Juander28/TFT-MMM-LAB-PDK/docs/figures/klayout_cap.png

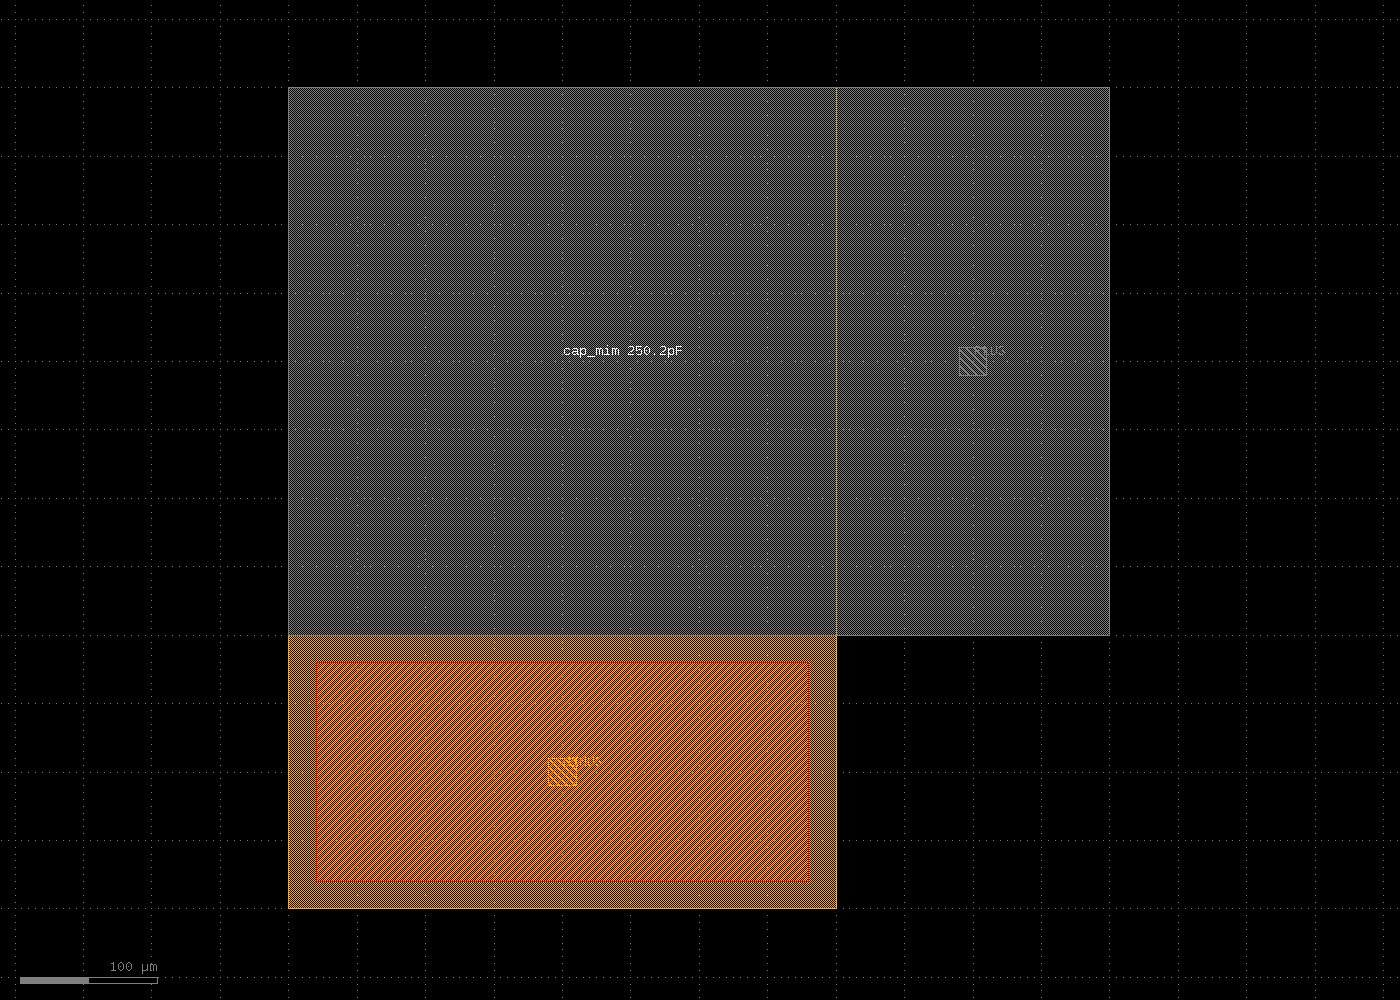
docs/figures/klayout_cap.png
