Juander28/TFT-MMM-LAB-PDK/docs/figures/klayout_cap_40p36.png

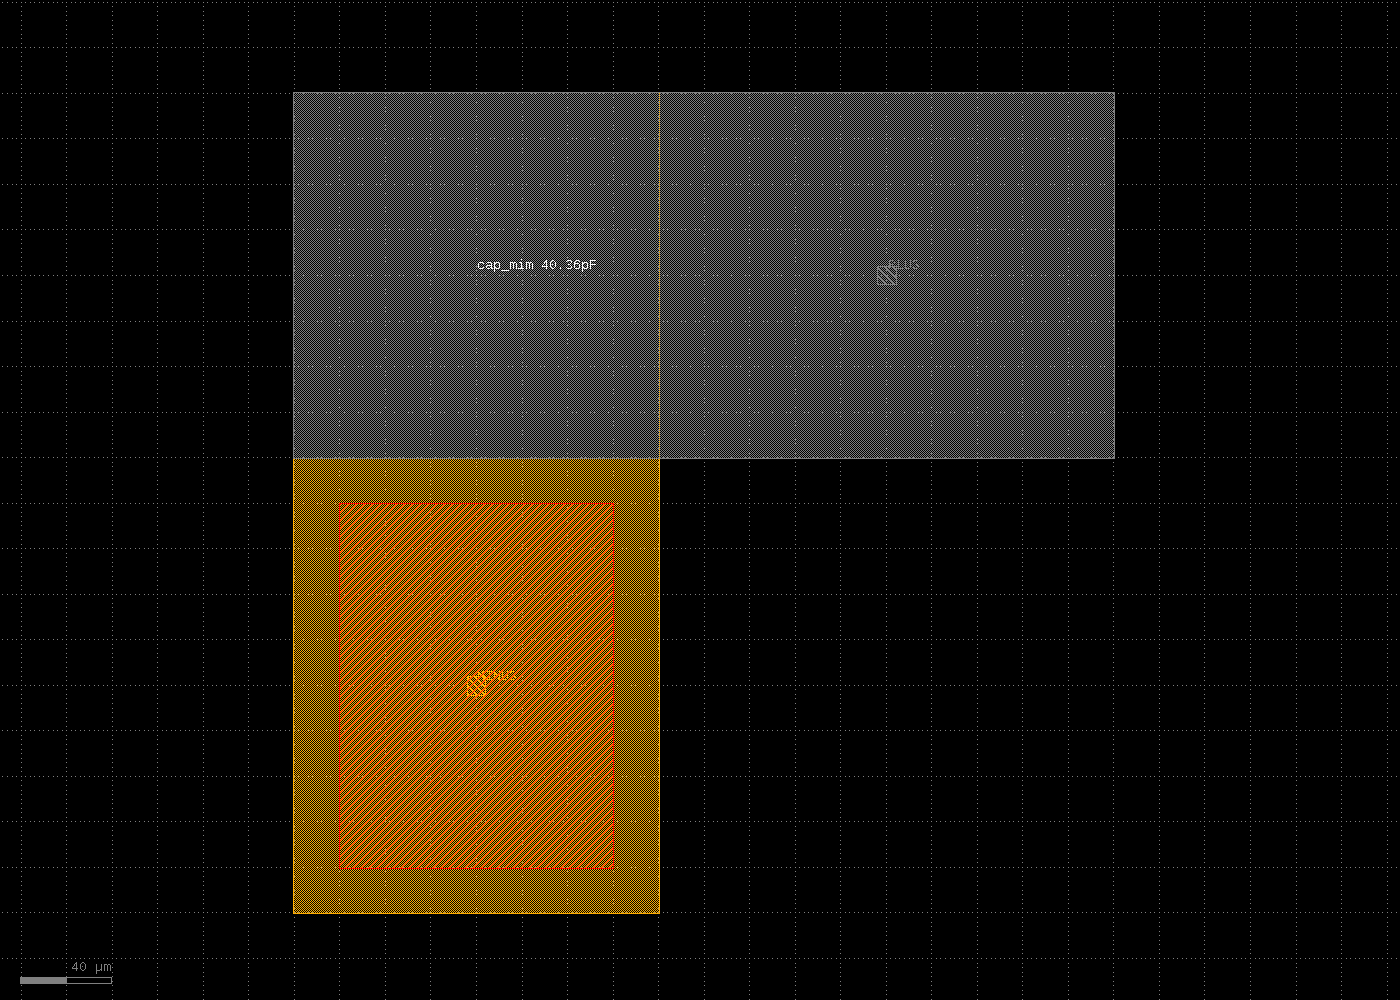
docs/figures/klayout_cap_40p36.png
