Juander28/TFT-MMM-LAB-PDK/docs/figures/klayout_ind_ci_series.png

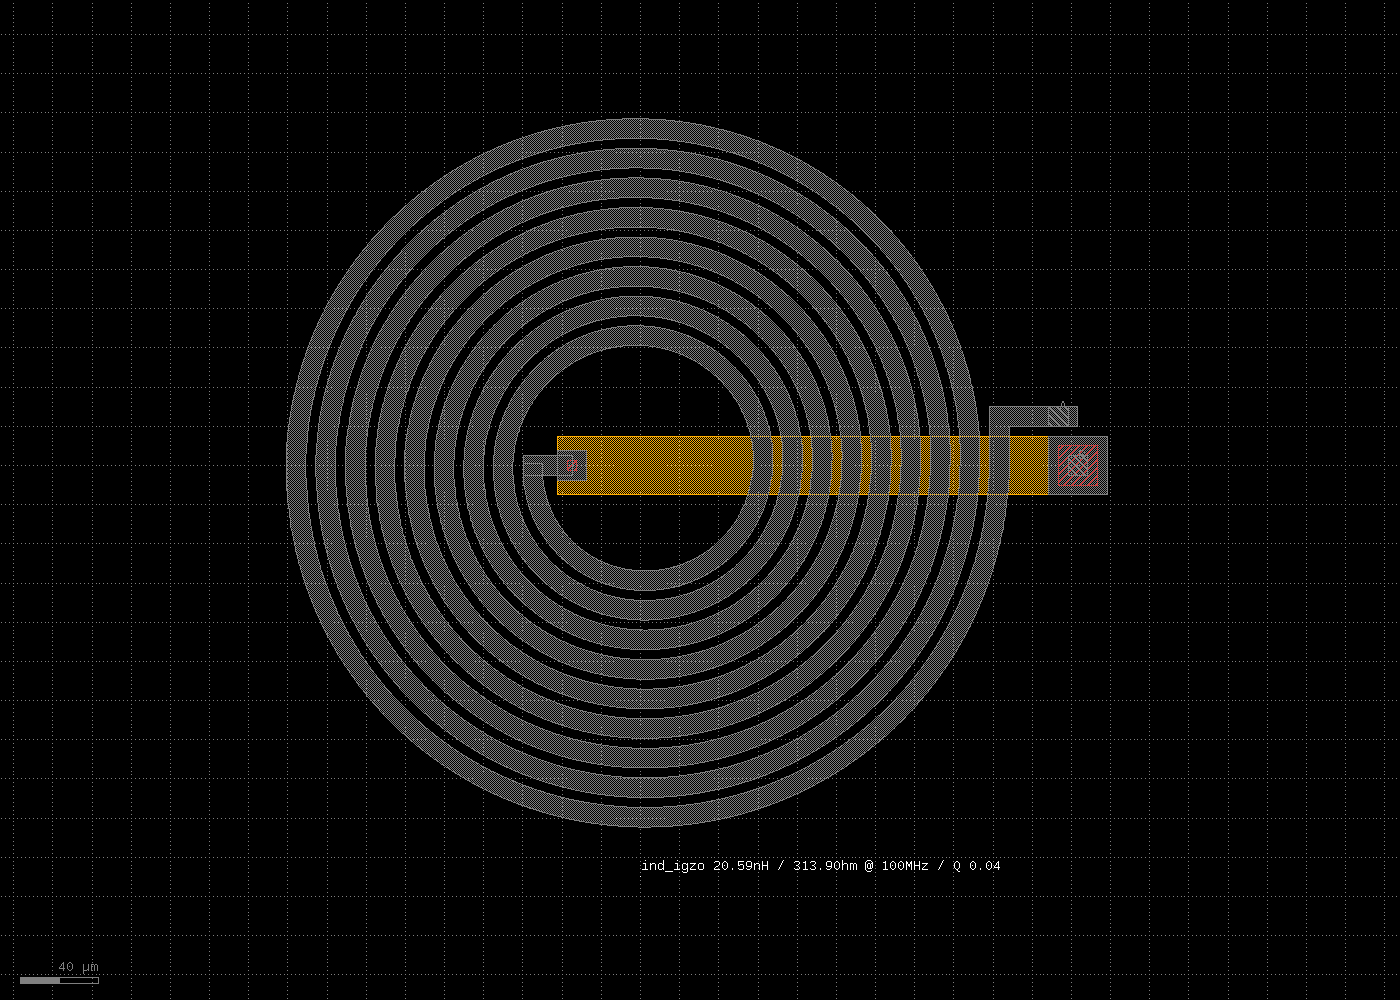
docs/figures/klayout_ind_ci_series.png
