Juander28/TFT-MMM-LAB-PDK/docs/figures/klayout_ind_sq_parallel.png

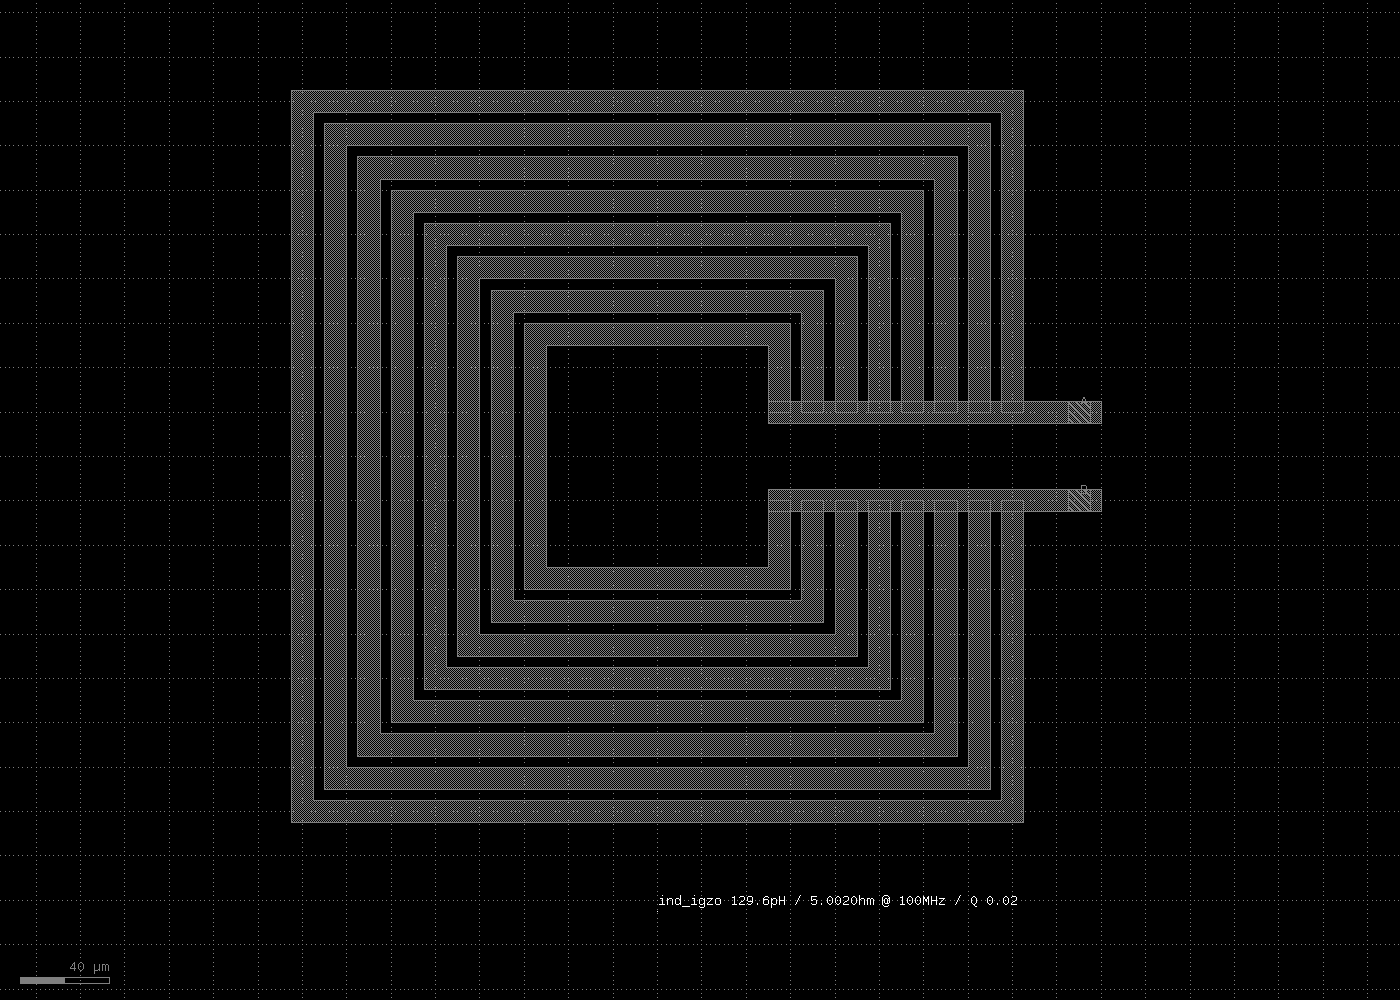
docs/figures/klayout_ind_sq_parallel.png
