Juander28/TFT-MMM-LAB-PDK/docs/figures/klayout_ind_tank.png

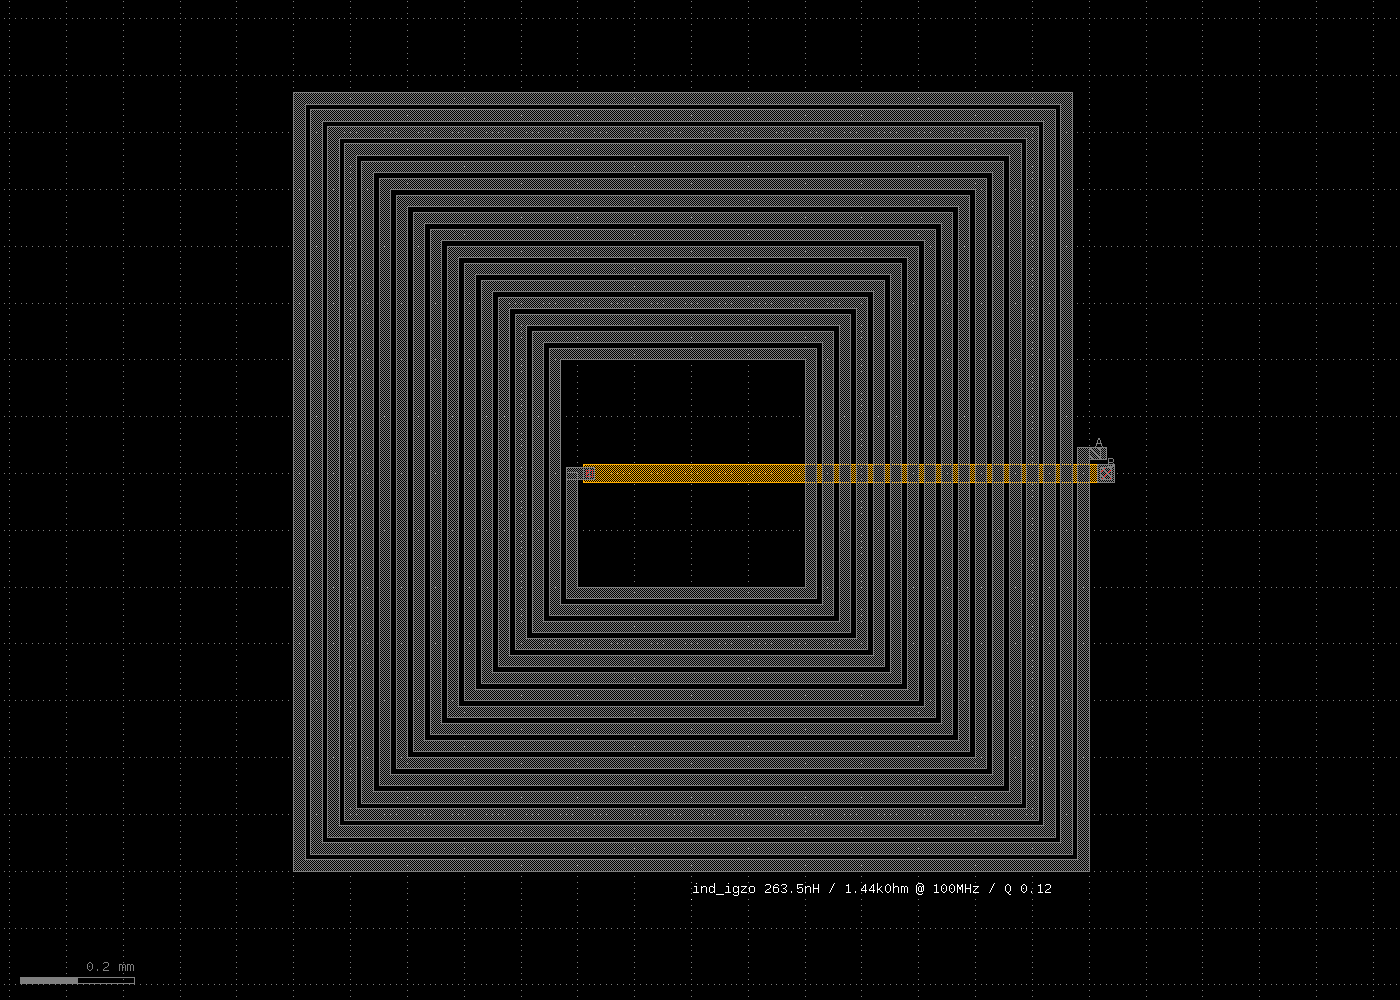
docs/figures/klayout_ind_tank.png
