Juander28/TFT-MMM-LAB-PDK/docs/figures/klayout_screen_crop.png

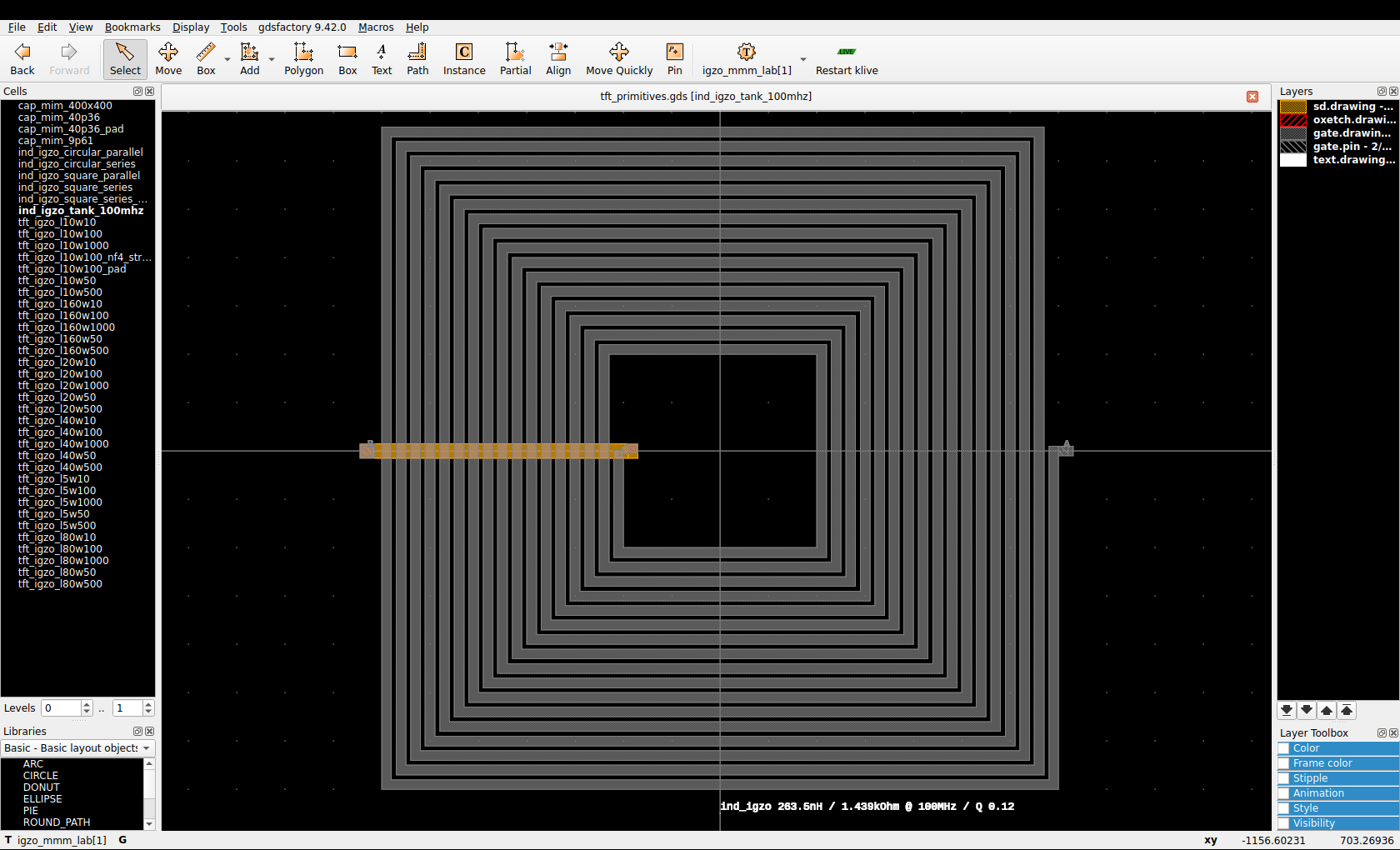
docs/figures/klayout_screen_crop.png
