Juander28/TFT-MMM-LAB-PDK/docs/figures/klayout_tft_big.png

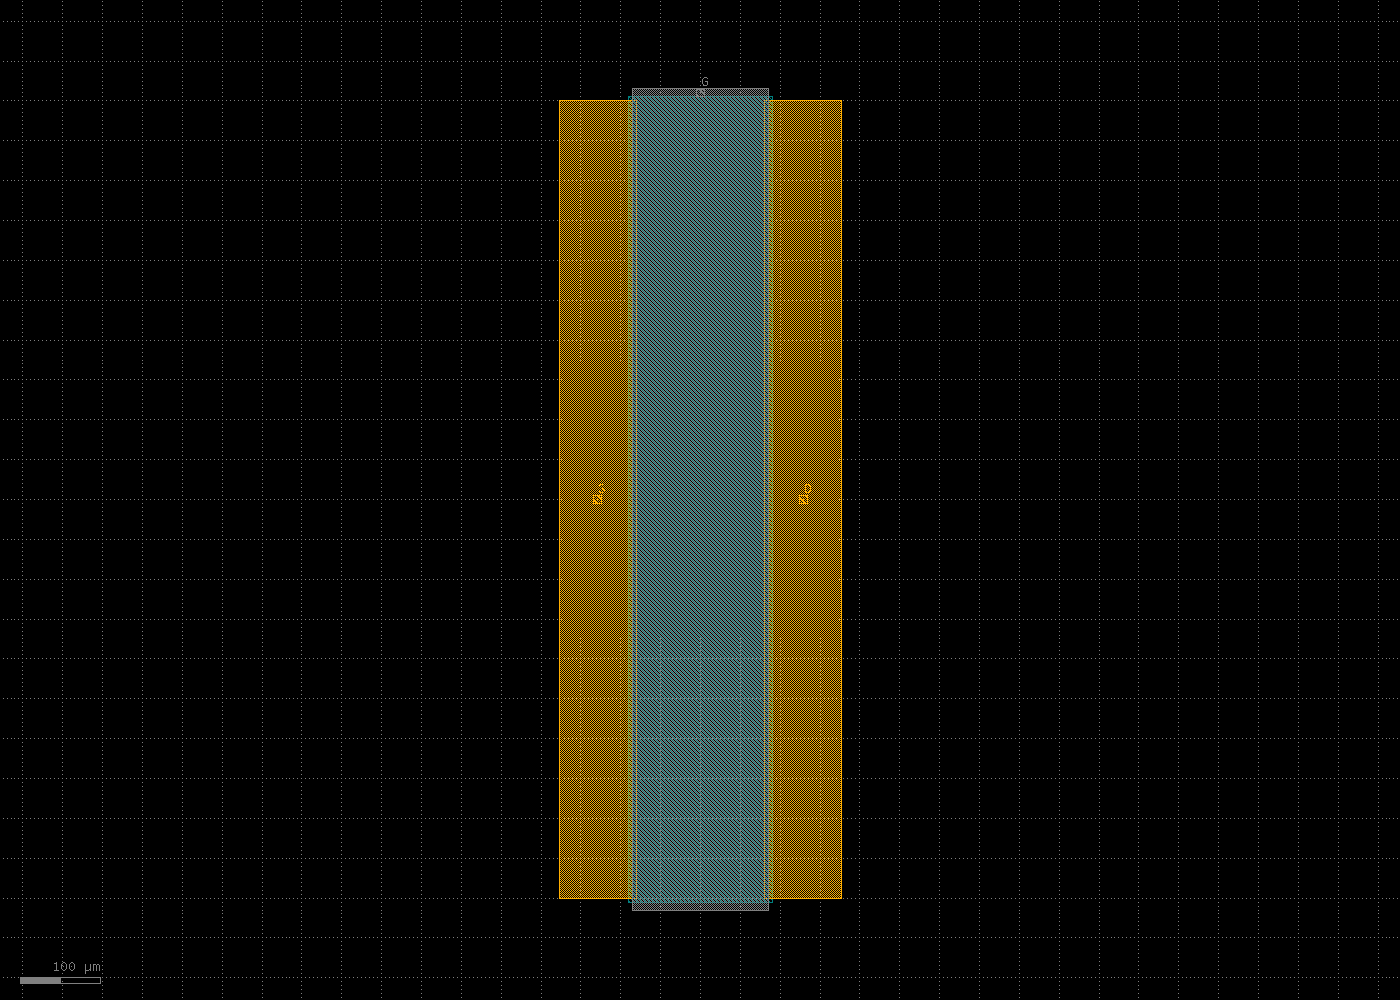
docs/figures/klayout_tft_big.png
