Juander28/TFT-MMM-LAB-PDK/docs/figures/klayout_tft_core.png

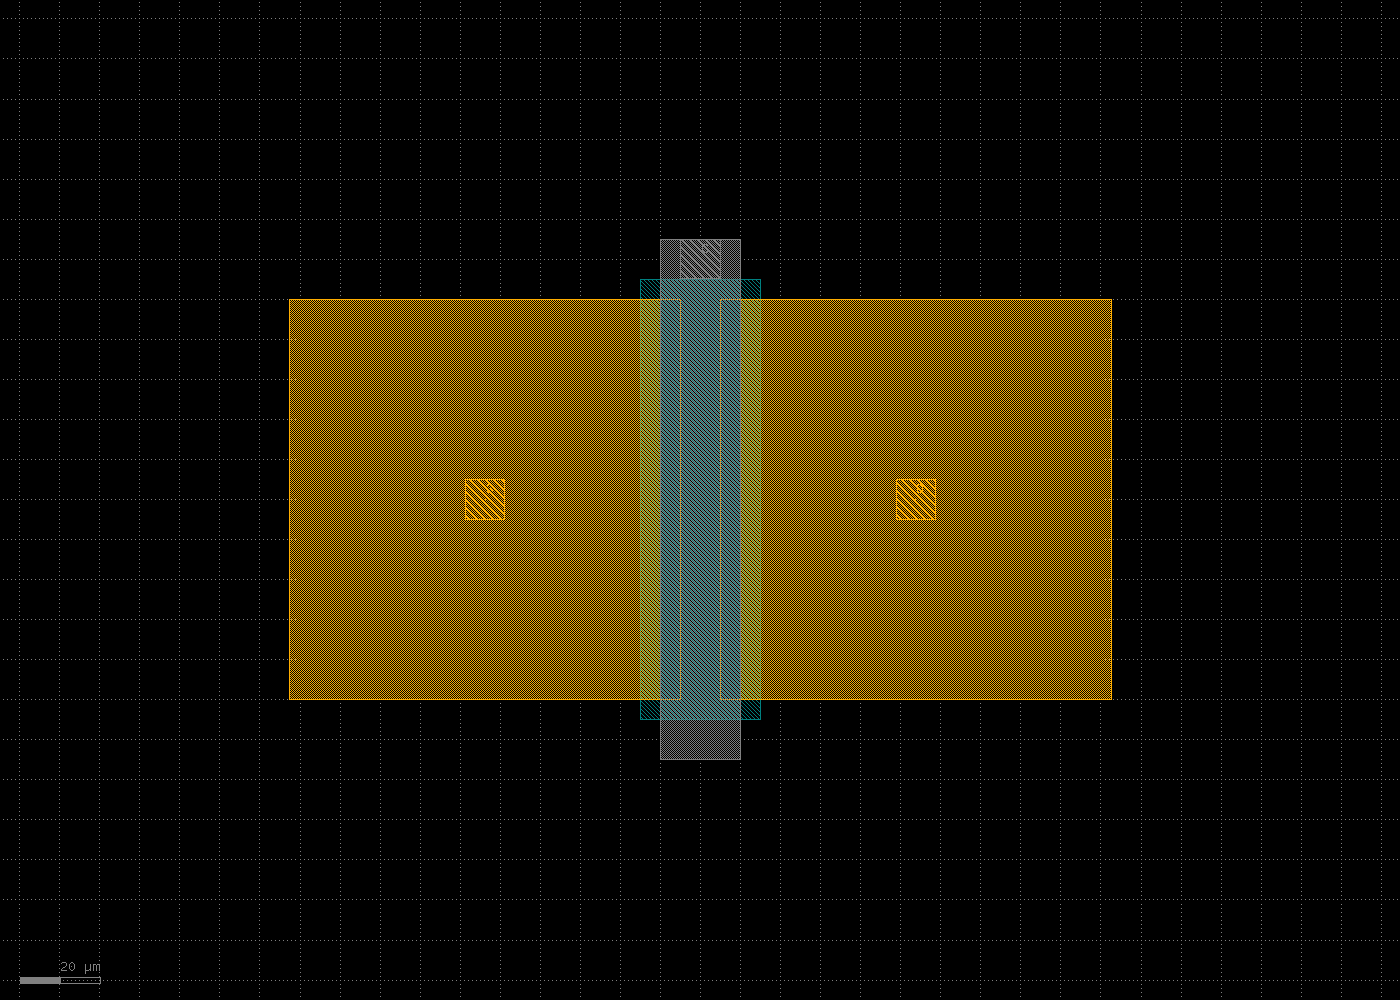
docs/figures/klayout_tft_core.png
