Juander28/TFT-MMM-LAB-PDK/docs/figures/klayout_tft_pad.png

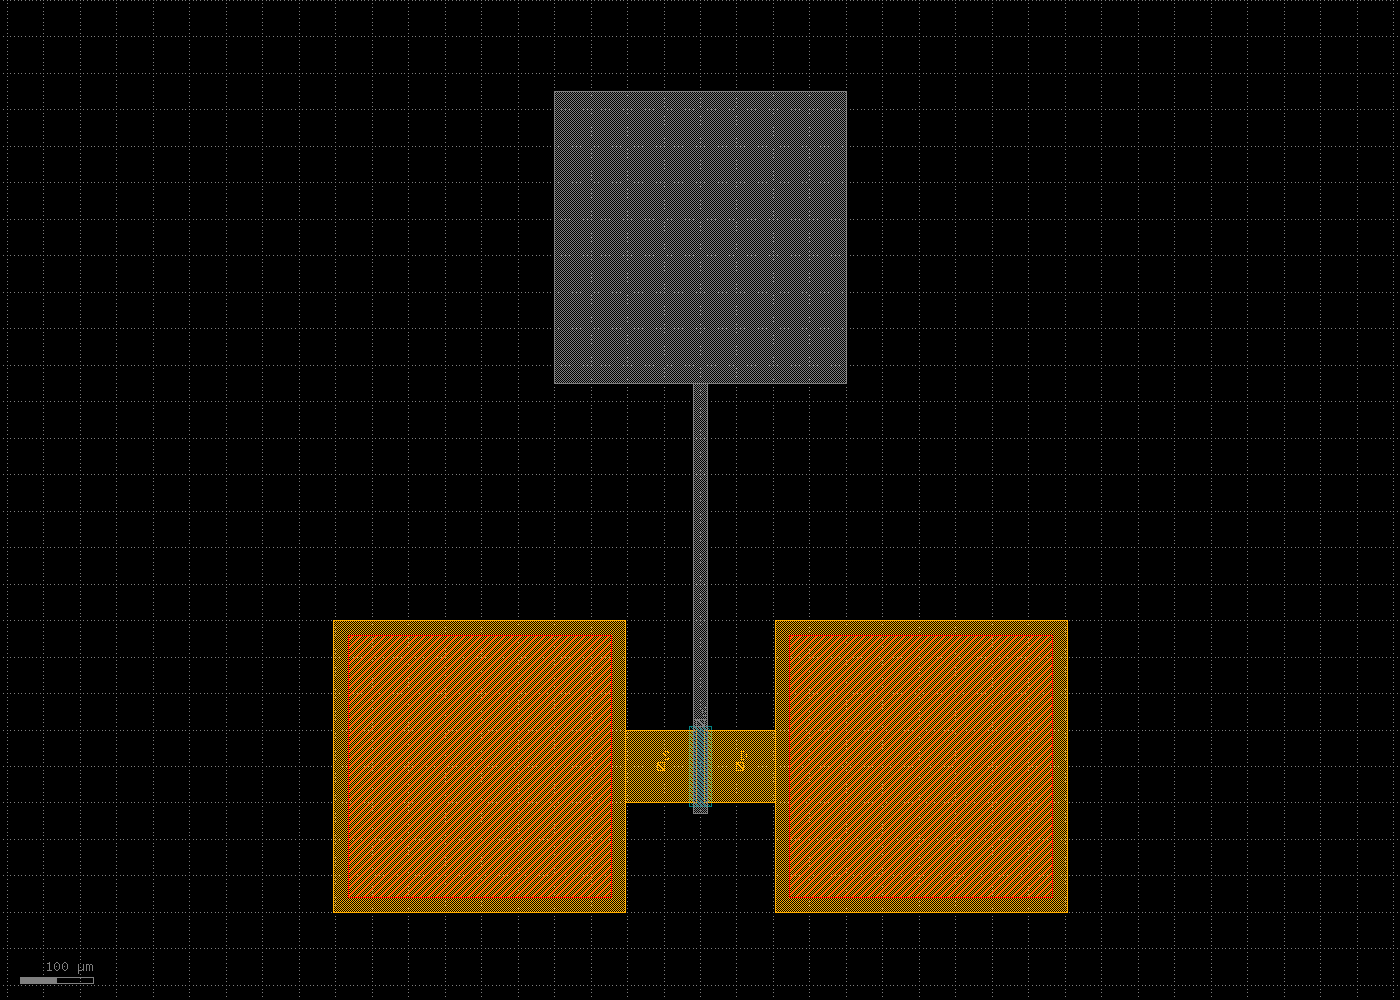
docs/figures/klayout_tft_pad.png
