Juander28/TFT-MMM-LAB-PDK/docs/figures/klayout_tft_straps.png

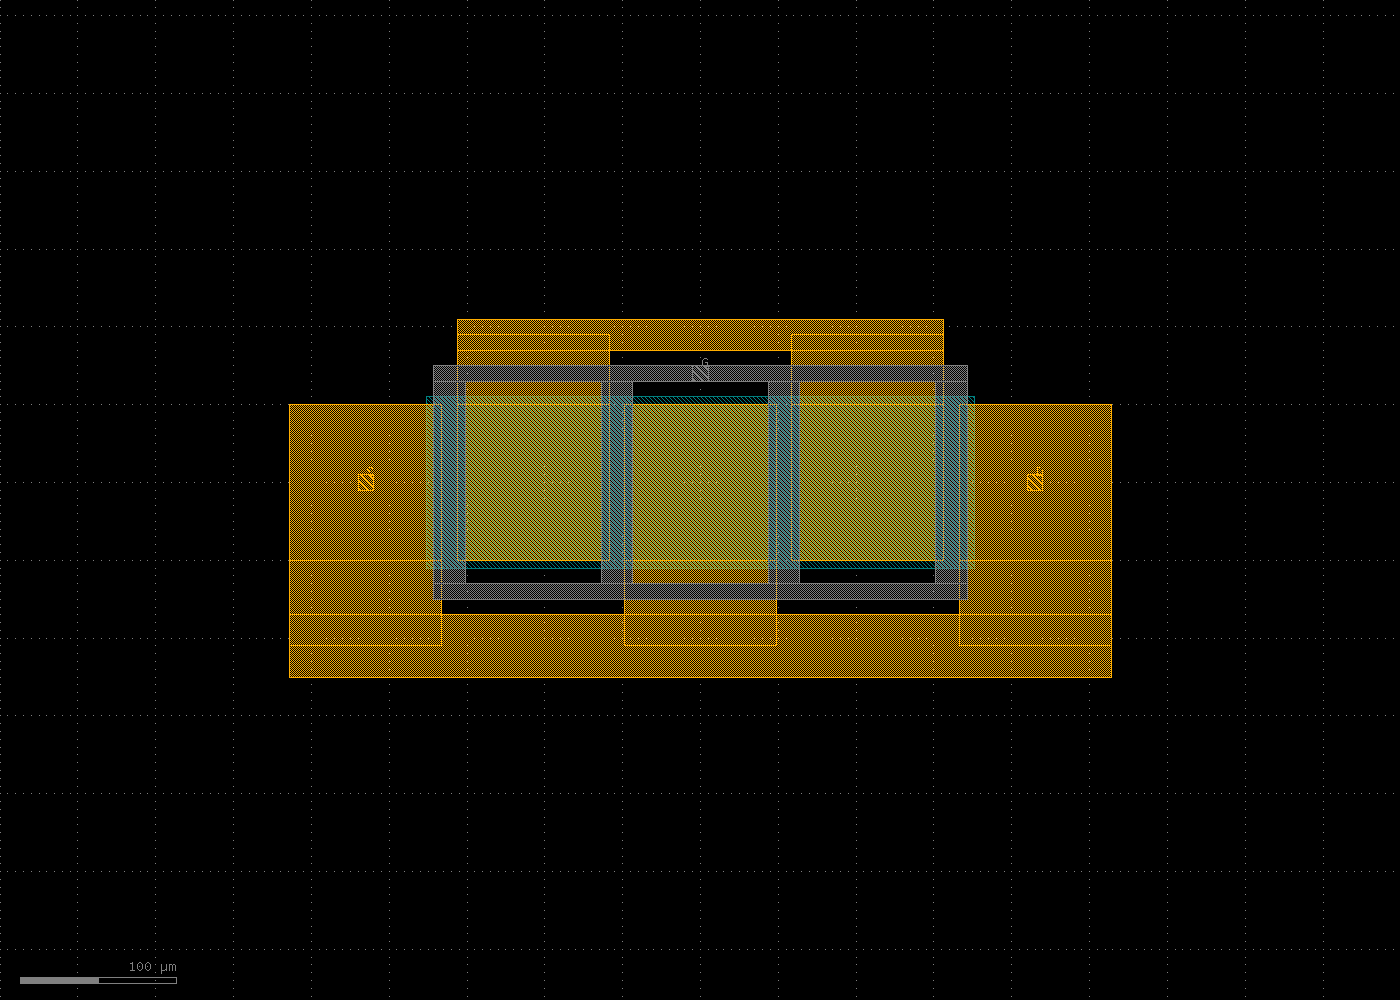
docs/figures/klayout_tft_straps.png
