Juander28/TFT-MMM-LAB-PDK/docs/figures/klayout_tft_zoom.png

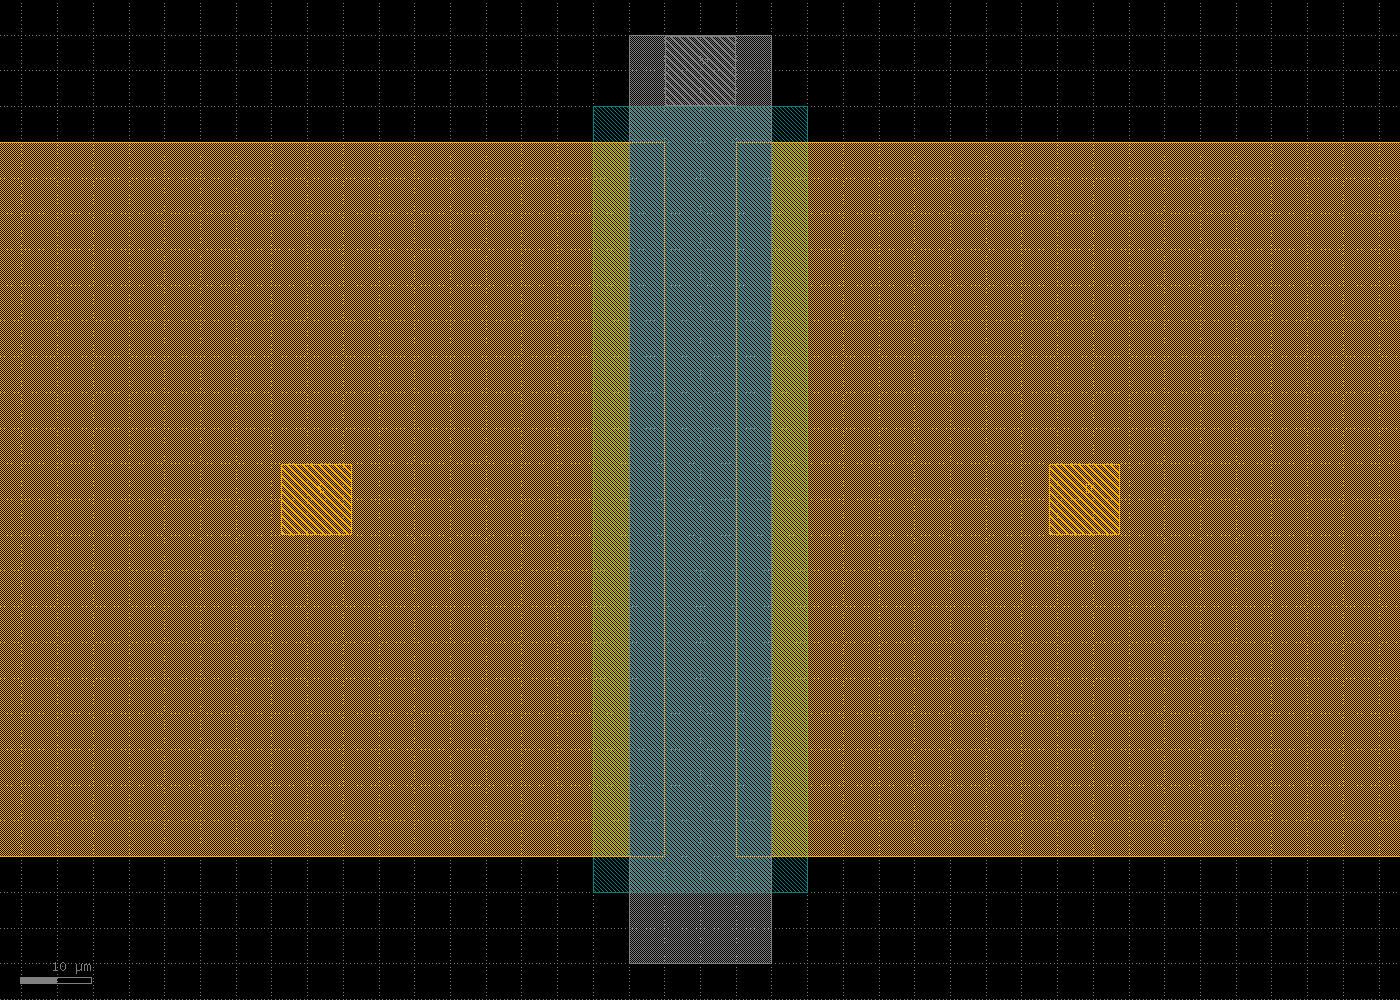
docs/figures/klayout_tft_zoom.png
