Juander28/TFT-MMM-LAB-PDK/docs/figures/magic_screen_core.png

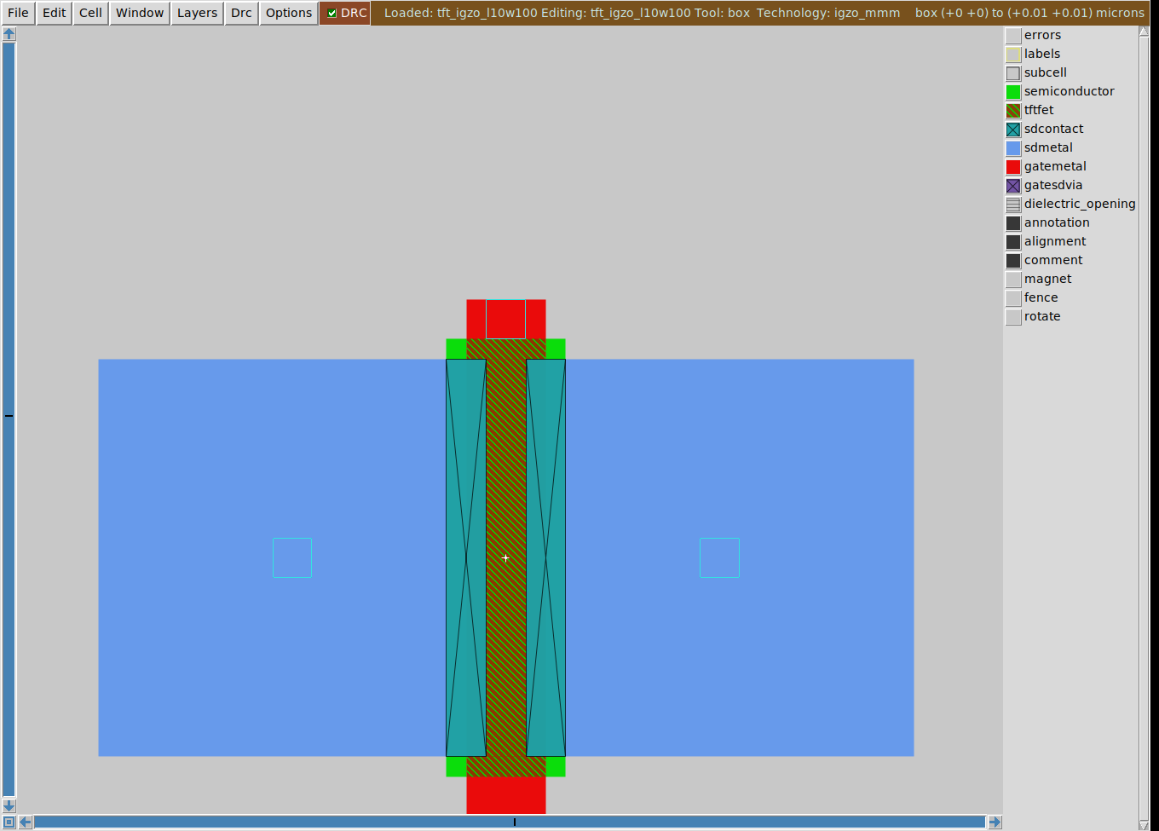
docs/figures/magic_screen_core.png
