Juander28/TFT-MMM-LAB-PDK/docs/figures/magic_screen_pad.png

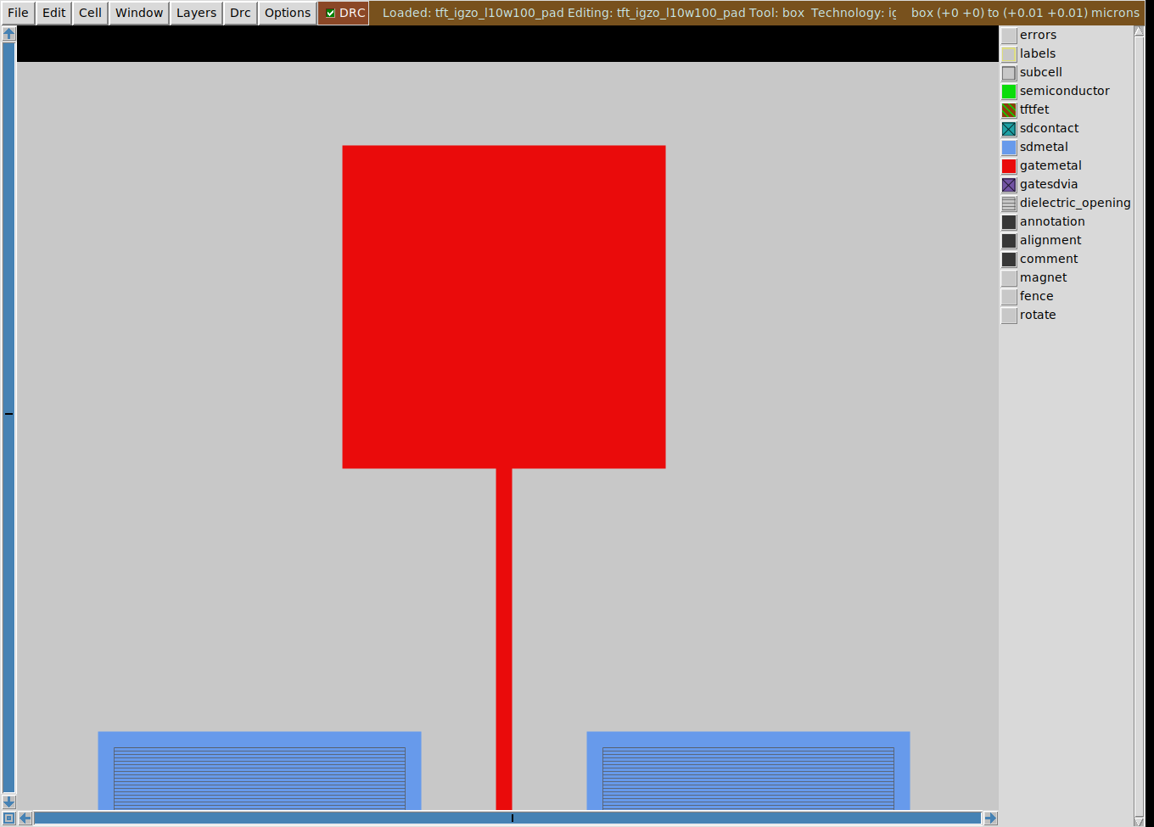
docs/figures/magic_screen_pad.png
