Juander28/TFT-MMM-LAB-PDK/docs/figures/xschem_bfield.png

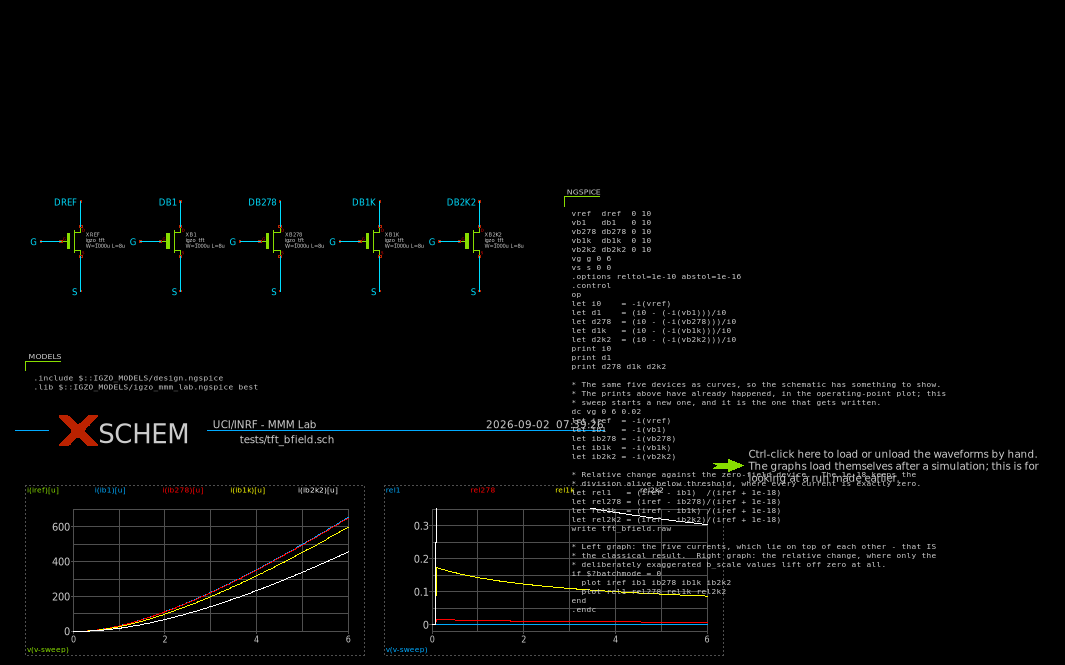
docs/figures/xschem_bfield.png
