Juander28/TFT-MMM-LAB-PDK/docs/figures/xschem_cv.png

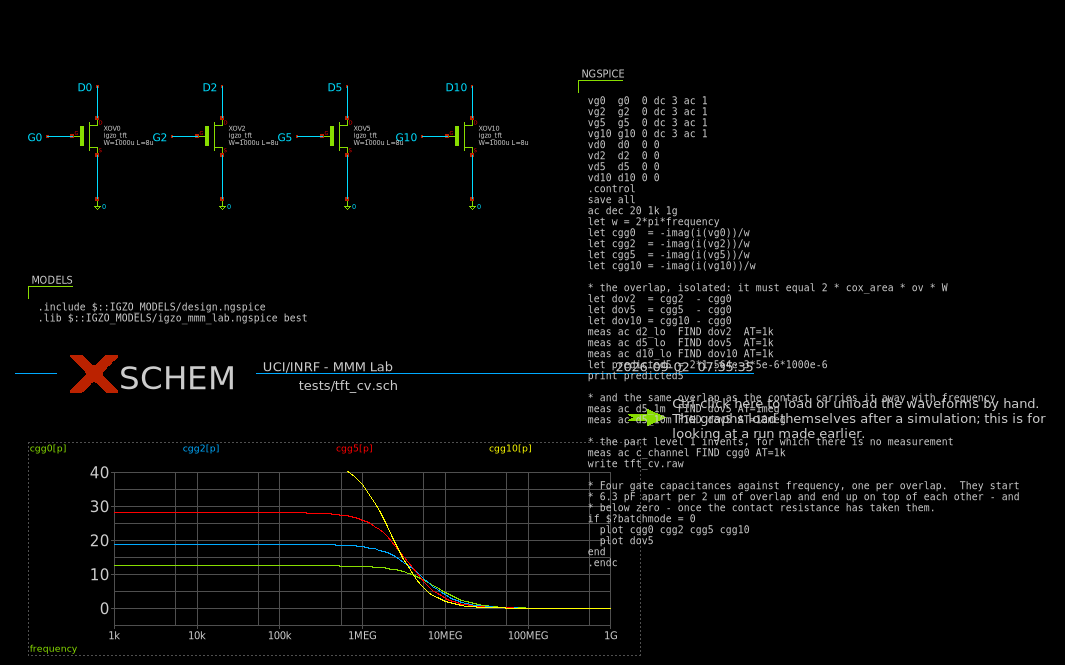
docs/figures/xschem_cv.png
