Juander28/TFT-MMM-LAB-PDK/docs/figures/xschem_diode.png

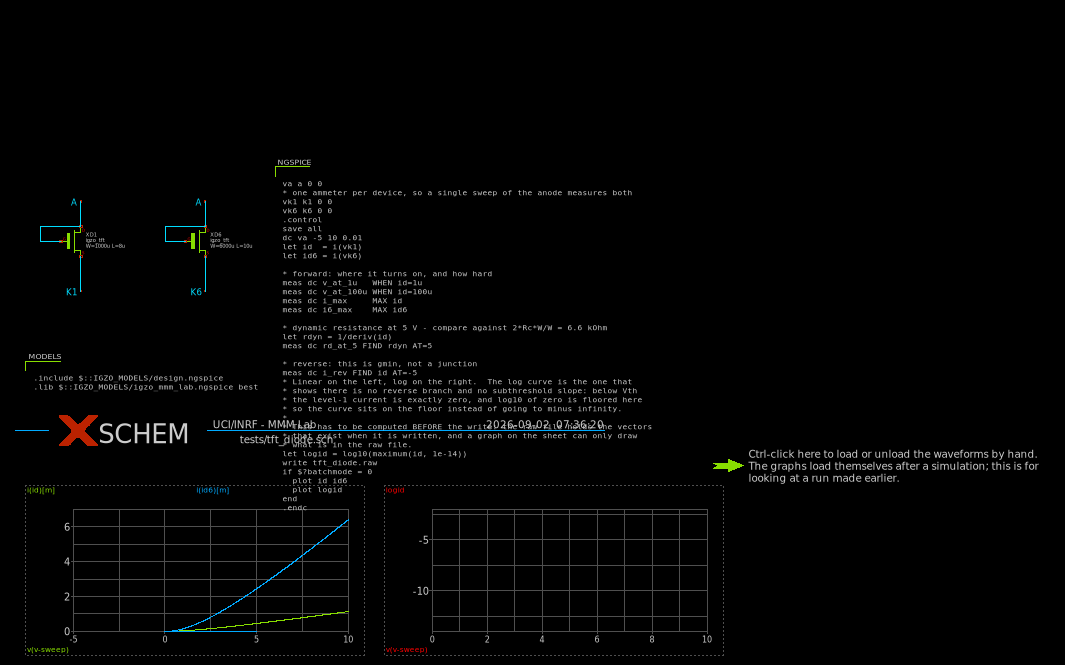
docs/figures/xschem_diode.png
