Juander28/TFT-MMM-LAB-PDK/docs/figures/xschem_index.png

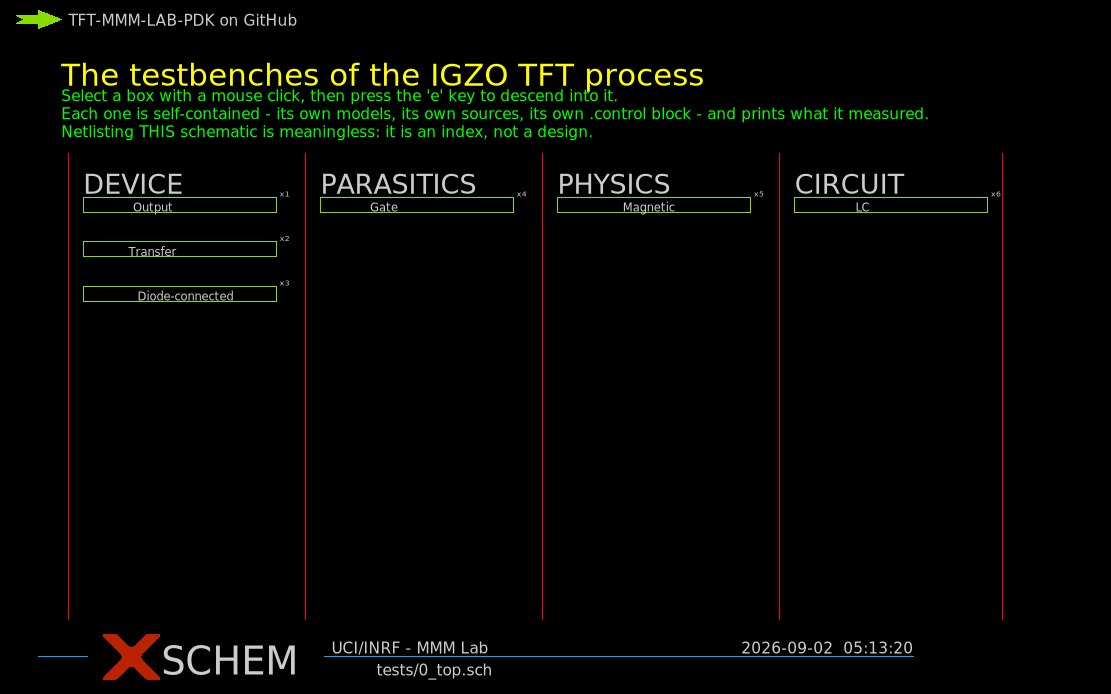
docs/figures/xschem_index.png
