Juander28/TFT-MMM-LAB-PDK/docs/figures/xschem_lvs.png

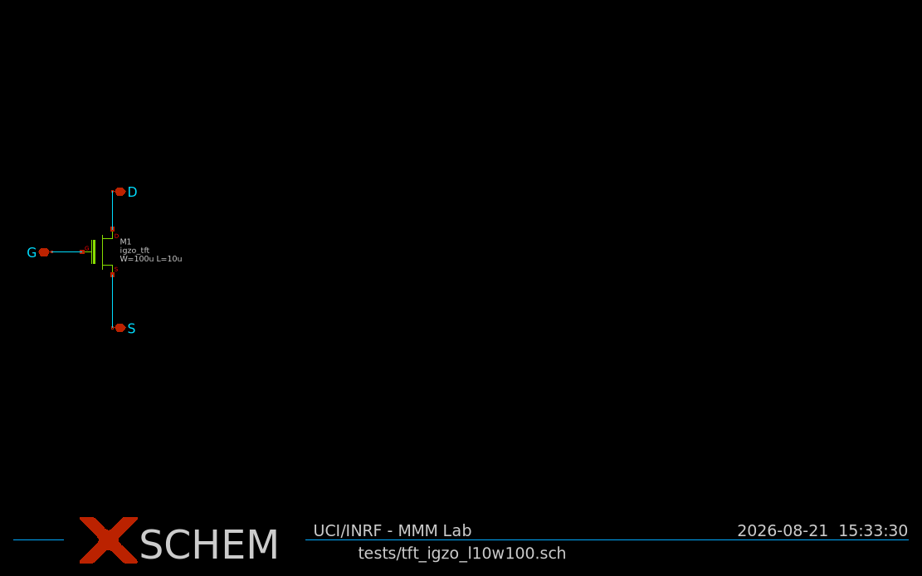
docs/figures/xschem_lvs.png
