Juander28/TFT-MMM-LAB-PDK/docs/figures/xschem_sym.png

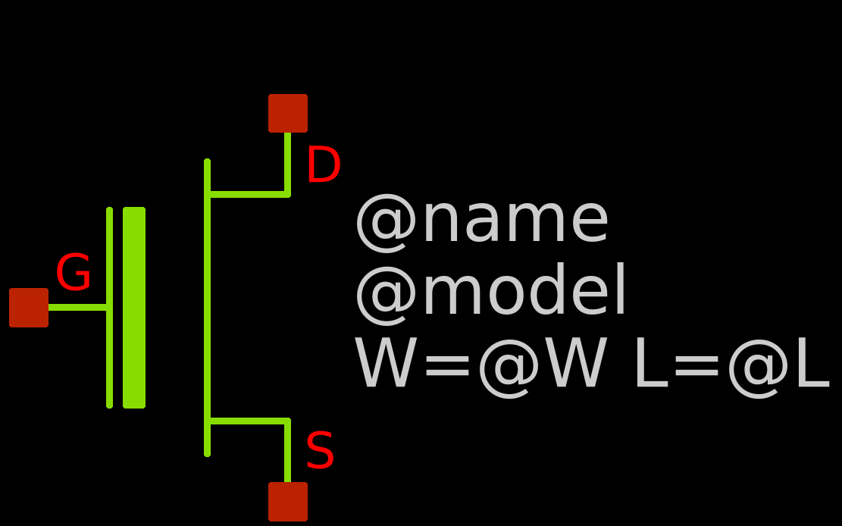
docs/figures/xschem_sym.png
