Juander28/TFT-MMM-LAB-PDK/docs/figures/xschem_tank.png

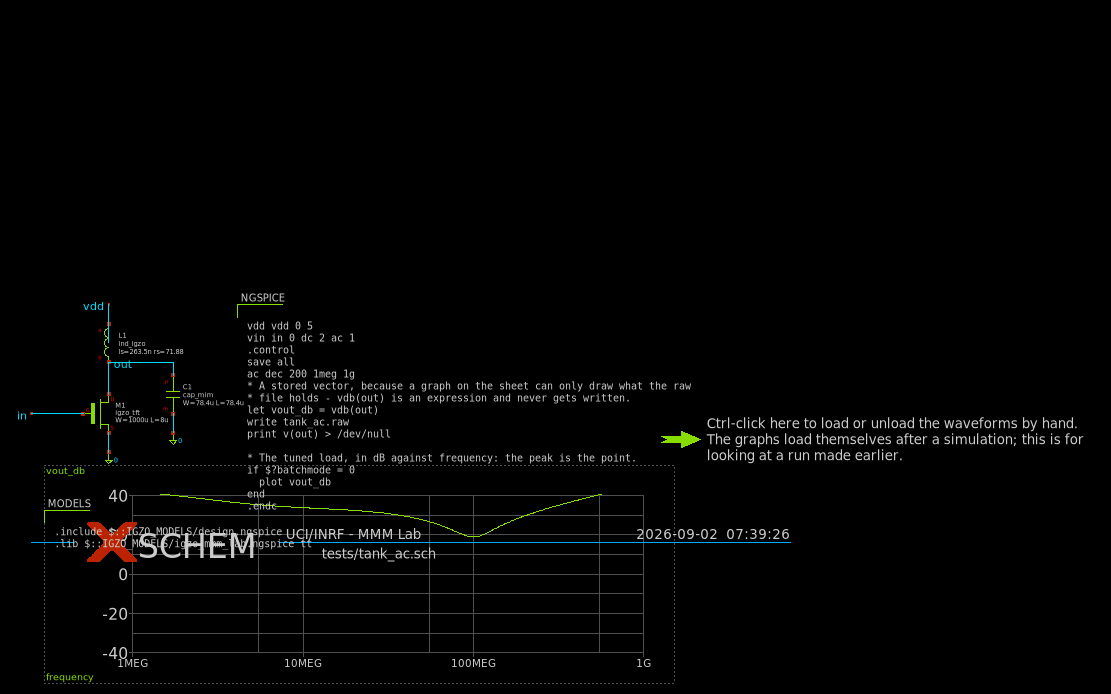
docs/figures/xschem_tank.png
