Juander28/TFT-MMM-LAB-PDK/docs/figures/xschem_tb.png

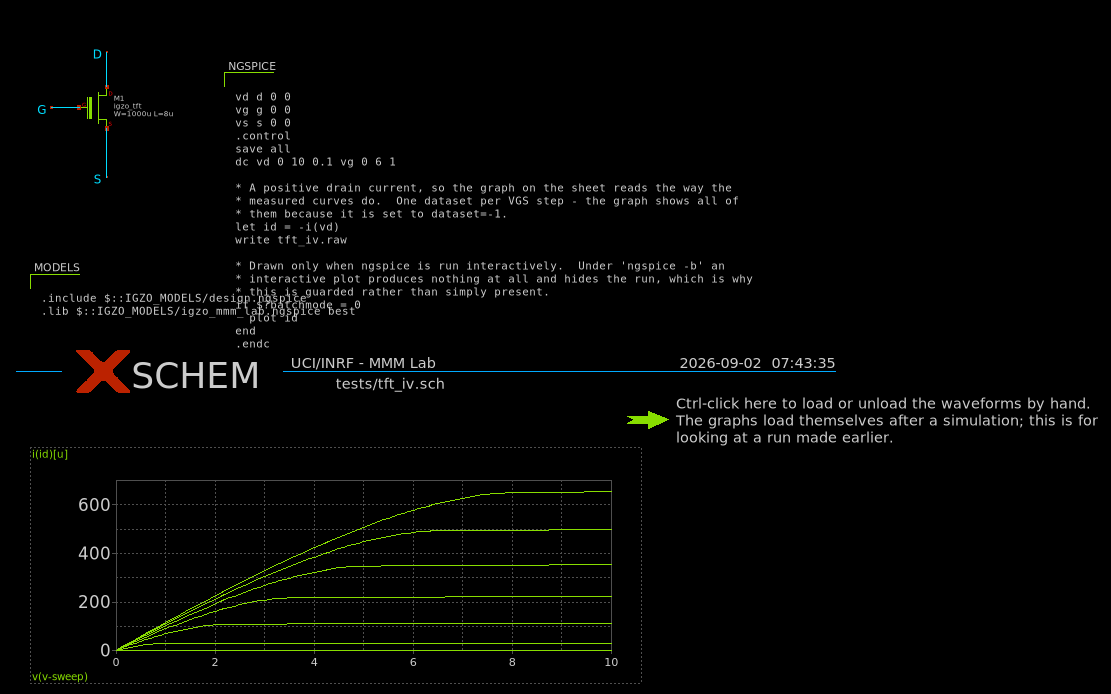
docs/figures/xschem_tb.png
