Juander28/TFT-MMM-LAB-PDK/docs/figures/xschem_transfer.png

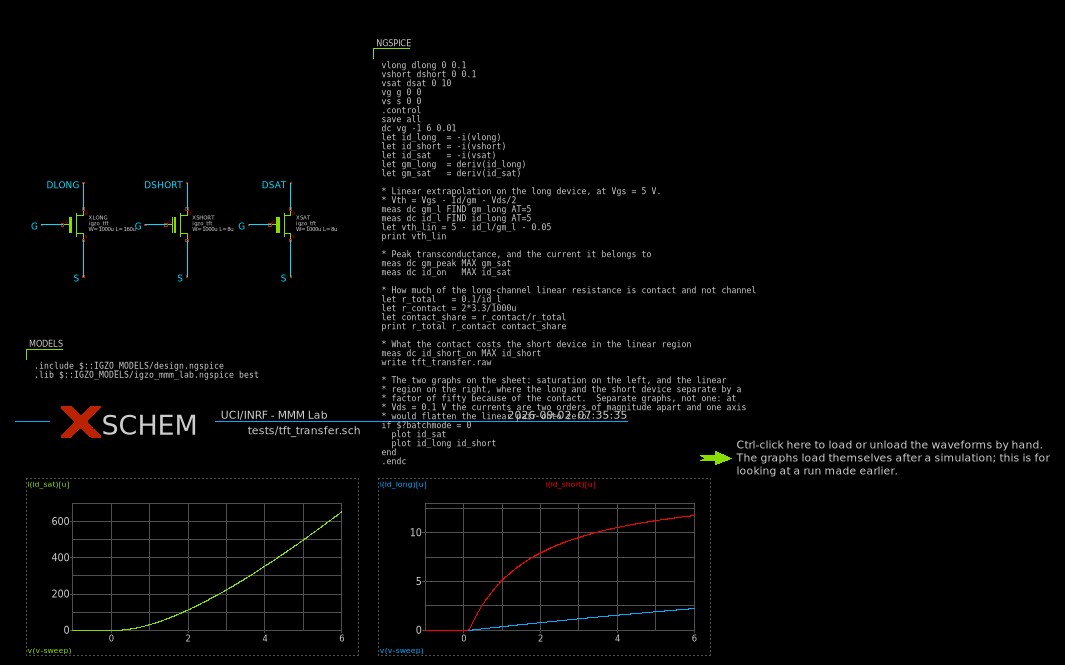
docs/figures/xschem_transfer.png
