Juander28/TFT-MMM-LAB-PDK/(list of files, drawings)

Other design files:
libs.tech/klayout/tech/igzo_mmm_lab.lyt
