Juander28/TFT-MMM-LAB-PDK/(commit log)

2026-08-21 Initial PDK for the UCI/INRF IGZO TFT process
    Packages the measured IGZO TFT process as a PDK that klayout, xschem,
    ngspice and magic use the same way they use gf180mcuD or sky130A.
    Four masks, top-gate coplanar: igzo (4/0), sd (6/0), oxetch (5/0),
    gate (2/0), plus alignment marks. The gate dielectric is a blanket ALD
    film with no mask of its own.
    klayout igzo_mmm_lab.{lyt,lyp,map}; tft_igzo and cap_mim PCells whose
    defaults reproduce the fabricated TFT-10L100W shape for shape;
    a preliminary DRC deck
    xschem tft_igzo.sym with pins D G S B, xschemrc, two testbenches
    ngspice four corner sections plus an igzo_tft wrapper carrying the
    measured contact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
    [igzo_mmm_lab.lyt, tft_igzo_l10w100.sch, tft_iv.sch]
2026-08-21 magic: add the plot section, so `plot pnm` renders the layout
    Without it magic warns "No plot section in techfile, using defaults" and
    draws a blank page: the defaults only know MOS layer names, and none of
    this process's types are MOS layers. "default" plots every type with its
    display style, which is what makes screenshots and PNM plots of the
    device views possible.
    Also stop tracking PDFs: generated documents belong outside the repo.
    Claude-Session: https://claude.ai/code/session_01WVZD27jGAPWmVqqey9CPiL
2026-08-21 oxetch is a via, the TFT has three terminals, and the repo stands alone
    Three changes that belong together, because each one is a correction to
    something the PDK was asserting.
    The process model. The gate is deposited after the dielectric etch, so an
    opening with gate metal over it is a via between the two metals - it is
    only a probe window where nothing covers it. The technology said the two
    conductors were never connected; that was wrong, and it is what makes a
    multi-turn spiral inductor possible at all. Both tools now model it:
    KLayout gets the 2/0-5/0-6/0 connection, magic a gsvia contact type derived
    through a templayer so the via is cut out of both metals. The old DRC rule
    that fl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
    [igzo_mmm_lab.lyt, tft_igzo_l10w100.sch, tft_iv.sch]
2026-08-22 Passive cells: a capacitor that sizes itself and an inductor that estimates
    cap_mim now answers the question in whichever direction it arrives. Set the
    plate, or the area, or the capacitance you need - the other two are read
    back, because all three are one formula, C = Cox * W * L, solved differently.
    The cell prints its own value on layer 63/0, a new annotation layer that is
    not a mask, so a layout opened later says what it is without reopening the
    parameter dialog.
    ind_igzo is new: square or circular, one spiral or n concentric rings in
    parallel, on either gold. The physics is not reimplemented - it calls
    tools/coil_core.py, the library from the coil calculator, so the PCell and
    the cal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
    [tank_ac.sch]
2026-08-22 Capacitor and inductor corrections, and everything lands on magic's grid
    What you asked for:
    cap_mim the plate extension is now four numbers, not one: ext_sd and
    ext_gate, because the two metals are not the same conductor and
    rarely want the same shape, plus ext_sd_far and ext_gate_far for
    catching a plate from both ends. Probe pads optional, with a
    dielectric window on the S/D pad since that metal is under the
    film.
    ind_igzo probe pads optional on both terminals, and terminals at all - it
    had no pins, which is why nothing could extract it.
    What the screenshots found, which is why they were worth taking:
    The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
2026-08-24 Fingers get straps, and pads overlap the tracks they sit on
    The coil pads butted against their leads: electrically fine on a drawing, a
    knife edge in silicon, where the whole connection rests on the mask landing
    exactly where it was drawn. They now overlap by a full track width.
    tft_igzo gains s_strap_w and d_strap_w. A folded device shares electrodes,
    so nf fingers means nf+1 terminals alternating source, drain, source - and
    until something ties them together that is what the layout is: nf+1 separate
    terminals, which run_checks.sh now asserts, along with the two nets you get
    once the straps are on. The two widths are separate because the two sides
    rarely carry the same current; zero on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
2026-08-24 An overview deck, in two languages
    Eleven slides: what the PDK is, the three cells with every parameter arrowed
    and explained, the model against the measured curves, and a closing slide
    that sorts every number into measured, read off the chip, assumed, or not
    known at all.
    The parameter panels are drawn from the live PCell declarations rather than
    typed out, so a panel cannot list a parameter the cell does not have, and the
    arrows point at row positions this script computed rather than at guessed
    coordinates.
    Two slides are worth the deck on their own. Simulated against measured says
    in the caption which is which - points measured, lines ngspice at each
    device's own W and L - because a pl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
2026-08-26 Terminals land in the middle of their pads, not on the edge
    The coil pads were connected and still wrong. The outer via sat on the
    boundary of the pad it contacted and the lead stopped at the pad's edge: a
    10 um trace butting against a 200 um pad, and a via with metal on one side of
    it. Connected on a drawing, marginal in silicon - at a boundary, half of any
    misalignment takes contact area away instead of just moving it.
    Now the underpass runs on to the middle of its pad and the via sits there,
    enclosed on all four sides; the outer lead crosses into its pad and ends at
    the centre; and the ring buses do the same, with the jog to the pad centre
    standing inside the metal rather than at its c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
2026-08-26 Make the device symmetric, and give it a magnetic field
    The wrapper tied the intrinsic bulk to the source pin, so a device drawn
    with its source on the high side forward-biased the bulk-drain junction:
    654 uA one way round, 1414 uA the other. A real TFT has no body, and its
    two channel terminals are the same kind of terminal. Every junction on
    the model cards is now inert - IS, JS, CBD, CBS, CJ and CJSW all zero -
    and the wrapper's own parts were already symmetric, so swapping d and s
    changes nothing. The check script asserts it, at every corner, in
    saturation and in the linear region.
    The wrapper also takes B, in tesla, defaulting to zero: classical
    magnetoresistance, mu/(1+(mu*b_scale*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
2026-08-26 Let the coil's inner track flow into its via pad
    The pad at the centre of a series coil sat beside the track: the track's
    end cap covered a third of it and the rest hung over nothing, which is
    what "the connection does not quite touch" looks like. It is now a
    funnel - the track's own width at the mouth, the pad's width at the
    other end, metal all the way across.
    Both of its edges lean the same way, upwards and inwards, and its lower
    edge never dips below the height it entered at. Held horizontal and
    vertical the corners come out at 87-88 degrees on a curved track, and a
    corner just off square is a spacing violation under a euclidian metric;
    flared symmetrically it reaches back across the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
2026-08-26 Bibliography: what the literature says about fields and TFTs
    Collected for the B parameter, and grouped so the most common confusion in
    this literature cannot happen: a field applied while the film is being made
    is not a field applied while the transistor runs.
    The arithmetic leads, because it decides how to read every measurement that
    follows. At our own 4.58 cm2/Vs, classical magnetoresistance is two parts
    in ten million per tesla, and the largest linear response available - a
    split drain reading the Lorentz deflection - is 0.05 %/T. Two independent
    routes to that second number: mu*B from theory, and the published
    sensitivity-versus-mobility curve extrapolated down to our mobility.
    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
2026-08-26 A document on what can honestly be designed here, and what cannot
    The question behind it: one capacitance in this technology is measured, and
    the semiconductor's own capacitance is not. make_capabilities.py sorts every
    kind of design into solid, coarse and not supported, and says which box each
    one is in and why.
    Every number in it is computed while the document is built, by running
    ngspice against the PDK's own model files, so it cannot drift away from the
    models it describes. What that turned up is worth having:
    * fT is 1.20 MHz at L = 10 um and 1.88 MHz at L = 5 um - not the tens of
    megahertz one might assume. The 5 um gate overlap dominates: at ov = 0
    the same devices woul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
2026-10-01 An index of testbenches, and every sheet draws its own signals
    sky130A and gf180mcuD both open on a page of clickable boxes; this PDK
    opened on nothing. tests/0_top.sch is that page - seven testbenches in
    four columns, select a box and press 'e' to descend. The mechanism is a
    naming convention and nothing else, so build_test_symbols.py generates
    the symbols and the index from one declarative list.
    Six of the seven are new: transfer curves, the diode-connected TFT, gate
    capacitance, the estimated C-V, and the magnetic field. Each is
    self-contained - its own models, its own sources, its own .control - and
    each carries a flags=graph rectangle with autoload=1, so simulating from
    xschem puts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
    [0_top.sch, tank_ac.sch, tft_bfield.sch, tft_cv.sch, tft_cv_estimated.sch, tft_diode.sch, tft_iv.sch, tft_transfer.sch]
2026-10-01 An estimated gate capacitance, so a circuit can be simulated before C-V
    The measured PDK knows one capacitance: Cox, from the 400 x 400 um
    plate. It knows nothing about the semiconductor's own, because no C-V
    sweep has been taken on a transistor - so every AC number this
    laboratory has produced rests on the oxide alone.
    igzo_cv_estimated.ngspice supplies the missing half from published
    a-IGZO values, and says so on every line. eps_r = 16 is from Chasin et
    al., Nature Communications 6, 7561 (2015); the 30 nm film thickness is
    this PDK's own; n = 1e16 cm^-3 is used only to check that the film fully
    depletes, which it does - the Debye length is 48 nm, longer than the
    film, so C_semiconductor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
2026-10-01 Label D on a drain, not on whichever electrode came last
    A folded transistor alternates S, D, S, D ... from the left, so the last
    electrode is a drain only when nf is odd. With nf even it is a source,
    and the D port landed on the source net: magic then reported D and S
    shorted and LVS failed on pins.
    electrodes[1] is a drain for every nf.
2026-10-01 The coil's inner terminal, built out of rectangles only
    The mouth that took the coil's inner end into its via pad was a
    four-point polygon with both edges leaning; the terminal left on the
    opposite side from the outer one; and there was no way to ask for the
    coil without it. All three are gone.
    RECTANGLES. _funnel() and _taper() are deleted - the second was dead
    code and the only other oblique polygon in the file. The crossing is
    now four pya.Box: the mouth, whose left edge sits exactly on the track's
    own left edge so the union is a T with four right angles and nothing
    over; the via's pad, wider because VIA.2 wants 5 um of gate all round a
    5 um opening and the track is only 10 um across;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
2026-10-01 Extraction sees a bought capacitor, and a coil, as devices
    Two things this process makes that no mask layer describes.
    A surface-mount capacitor is soldered on after the four masks. What the
    process makes is its two pads, so extraction saw two pieces of metal and
    no device. smd.body 70/0 and smd.term 70/1 are markers - never
    fabricated - that magic reads as one smd_cap between the pads, with the
    value carried in the body's AREA: 1 um^2 per nF. The PCell draws that
    area exactly on the 10 nm grid for the value typed in, so the
    capacitance extracted from the layout is the capacitance asked for, and
    netgen checks it against the schematic.
    The cell is smd_cap_pads and not smd_cap on purpose: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
2026-10-01 run_checks.sh: 23 checks, and each one can be broken on purpose
    Grew from 11 to 23 as the testbenches, the estimated C-V, the SMD
    capacitor and the rebuilt coil arrived. The ones worth naming:
    - every sheet in tests/ runs in batch and writes a raw file, and the
    nodes it graphs are compared against the vectors ngspice wrote;
    - the index is complete and every symbol descends into its schematic;
    - no oblique edge on any square coil, on 2/0, 6/0 or 5/0;
    - clearing inner_term leaves one piece of gate and nothing on S/D;
    - the sheet resistance magic carries and the one the coil prints agree
    to a tenth of a percent, measuring the same track;
    - the DRC list now includes the fou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
2026-10-01 Document the testbenches, and regenerate what they changed
    README gains the index of testbenches as a table, the note that each
    sheet draws its own signals, and why the plot calls sit behind a
    $?batchmode guard.
    The cell SOP and the overview slides pick up the coil's new inner
    terminal: the inductor's resistance is 379.0 Ohm, not 377.7, because the
    outer lead is now lifted clear of the underpass and that lift is 25 um
    of real metal. The thickness table is rescaled with it, and
    `inner_term` joins the parameter tables.
    The GDS, the magic views and the KLayout figures are regenerated from
    the PCells. Six xschem screenshots are new - one per testbench, taken
    with their waveforms on the sheet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
2026-10-01 install.sh: make the PDK work on a machine with no container
    Three things stood between a bare machine and a working PDK.
    xschem. klayout, ngspice and magic are all reached through environment
    variables, so use-pdk was enough for them. xschem reads a Tcl rc file,
    and a stock ~/.xschem/xschemrc knows about no PDK at all - opened that
    way every symbol on a test sheet reads IS MISSING, xschem's own devices/
    library included. install.sh now adds a marked block to that file which
    sources this PDK's xschemrc whenever use-pdk has selected one, guarded
    so that xschem still works when it has not.
    DESIGNS. Inside the container .designinit sets it; nothing does on a
    bare machine, so a cell instan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
